FifekAGH/Analogowy-Krehlik/README.md

# Wstępny podział 

Krzysztof - frontend

Dominik - STM32F3 + decoupling, pullupy/downy itp

Filip - LDO, Układ odwracający napięcie, USB,Diody LED :)
