FifekAGH/Analogowy-Krehlik/precise_ammeter/precise_ammeter.kicad_pcb

## KiCad design precise_ammeter/precise_ammeter.kicad_pcb (2025-11-12)

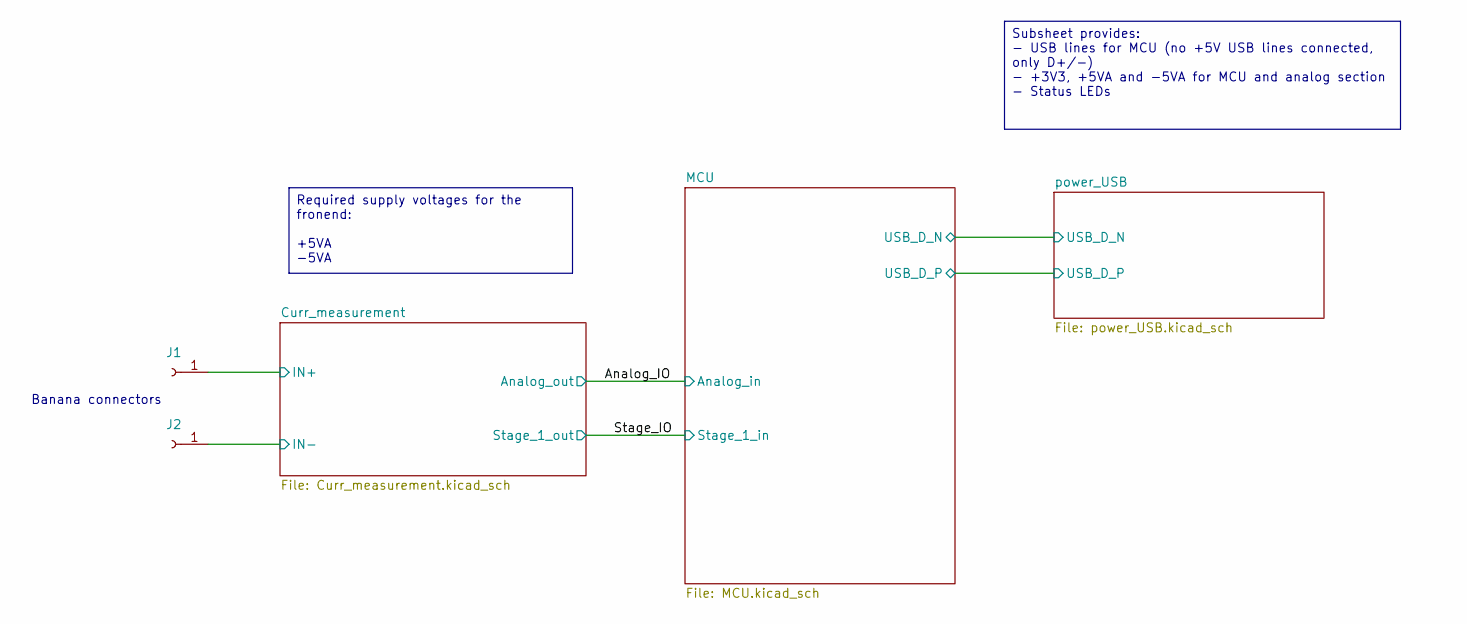
[picture p1: schematic precise_ammeter.kicad_sch]

Parts:
J1, J2: Conn_01x01_Socket; Banana_Jack_1Pin

Connections:
/Curr_measurement/IN+: J1.1; also elsewhere on the board
/Curr_measurement/IN-: J2.1; also elsewhere on the board

Notes on the sheet:
Banana connectors
Required supply voltages for the fronend: +5VA -5VA
Subsheet provides: - USB lines for MCU (no +5V USB lines connected, only D+/-) - +3V3, +5VA and -5VA for MCU and analog section - Status LEDs

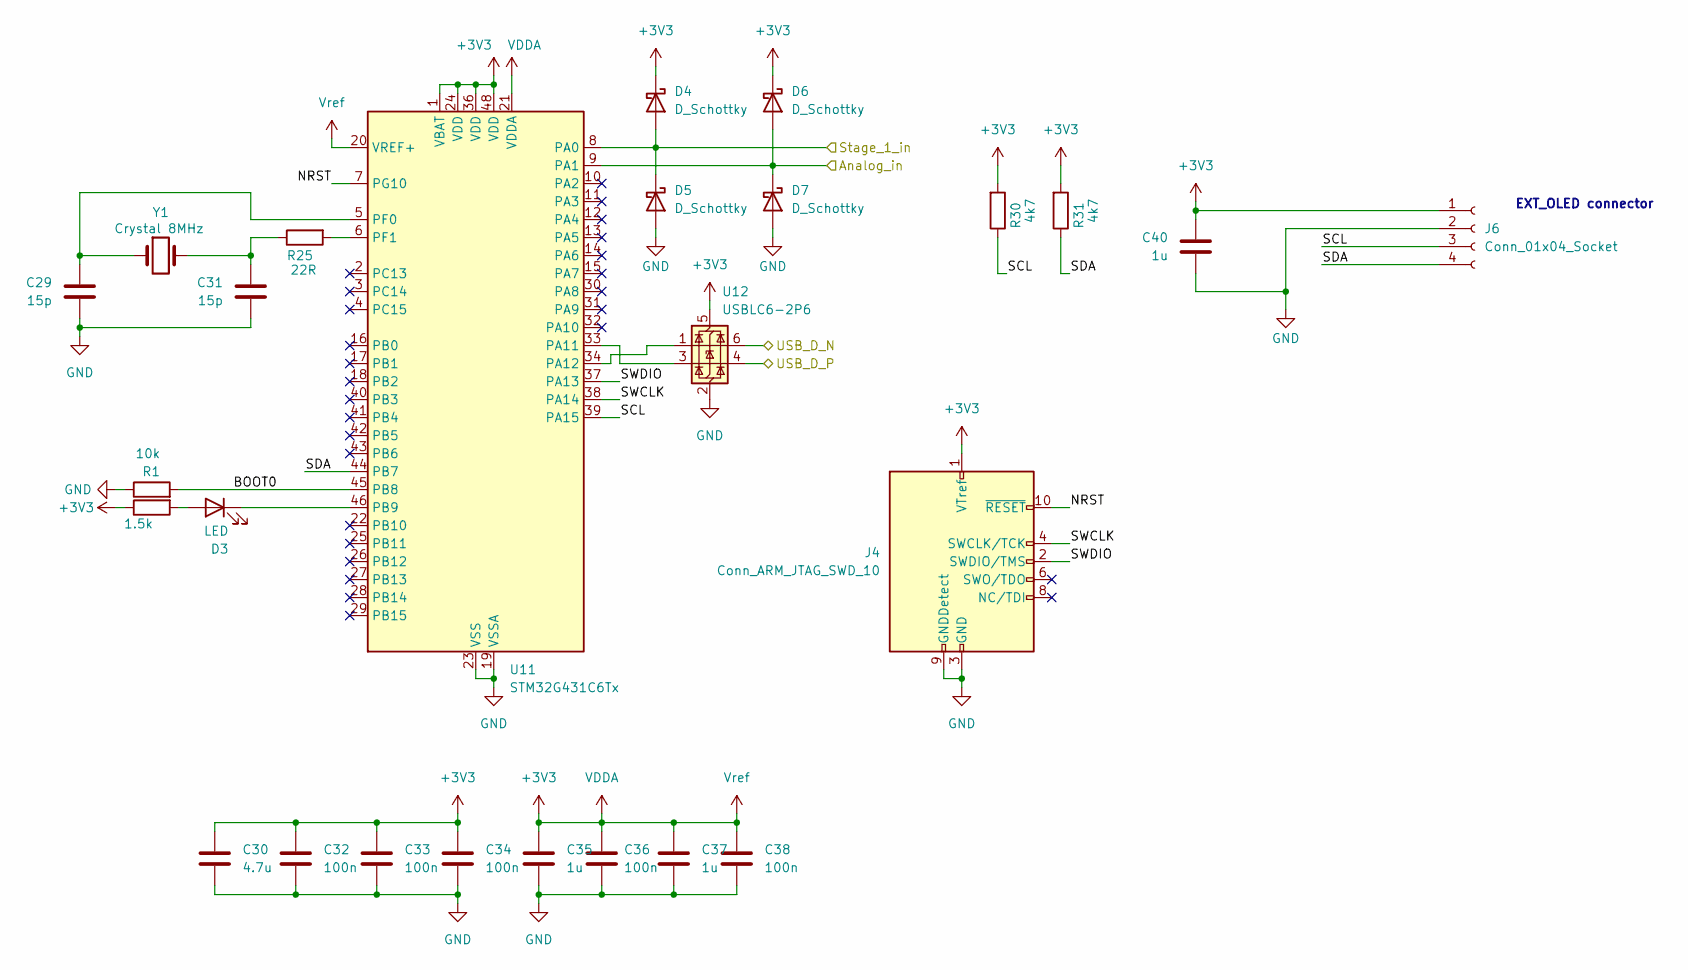
[picture p2: schematic MCU.kicad_sch]

Parts:
C29, C31: 15p; C_0805_2012Metric
C30: 4.7u; C_0805_2012Metric
C32, C33, C34, C36, C38: 100n; C_0805_2012Metric
C35, C37, C40: 1u; C_0805_2012Metric
D3: LED; LED_0805_2012Metric
D4, D5, D6, D7: D_Schottky; D_SOD-123F
J4: Conn_ARM_JTAG_SWD_10; PinHeader_2x05_P1.27mm_Vertical
J6: Conn_01x04_Socket; PinSocket_1x04_P2.54mm_Vertical
R1: 10k; R_0805_2012Metric_Pad1.20x1.40mm_HandSolder
R5: 1.5k; R_0805_2012Metric_Pad1.20x1.40mm_HandSolder
R25: 22R; R_0805_2012Metric_Pad1.20x1.40mm_HandSolder
R30, R31: 4k7; R_0805_2012Metric_Pad1.20x1.40mm_HandSolder
U11: STM32G431C6Tx; LQFP-48_7x7mm_P0.5mm
U12: USBLC6-2P6; SOT-666
Y1: Crystal 8MHz; Crystal_SMD_HC49-SD

Connections:
+3V3: C30.1, C32.1, C33.1, C34.1, C35.1, C36.1, C37.1, C38.1, C40.1, D4.1 (K), D6.1 (K), J4.1 (VTref), J6.1, R5.1, R30.2, R31.2, U11.1 (VBAT), U11.20 (VREF+), U11.21 (VDDA), U11.24 (VDD), U11.36 (VDD), U11.48 (VDD), U12.5 (VBUS); also elsewhere on the board
/Analog_IO: D6.2 (A), D7.1 (K), U11.9 (PA1); also elsewhere on the board
/MCU/BOOT0: R1.2, U11.45 (PB8)
/MCU/NRST: J4.10 (~RESET), U11.7 (PG10)
/MCU/SCL: J6.3, R30.1, U11.39 (PA15)
/MCU/SDA: J6.4, R31.1, U11.44 (PB7)
/MCU/SWCLK: J4.4 (SWCLK/TCK), U11.38 (PA14)
/MCU/SWDIO: J4.2 (SWDIO/TMS), U11.37 (PA13)
/MCU/USB_D_N: U12.6 (I/O1); also elsewhere on the board
/MCU/USB_D_P: U12.4 (I/O2); also elsewhere on the board
/Stage_IO: D4.2 (A), D5.1 (K), U11.8 (PA0); also elsewhere on the board
GND: C29.2, C30.2, C31.2, C32.2, C33.2, C34.2, C35.2, C36.2, C37.2, C38.2, C40.2, D5.2 (A), D7.2 (A), J4.3 (GND), J4.5 (GND), J4.9 (GNDDetect), J6.2, R1.1, U11.19 (VSSA), U11.23 (VSS), U11.35 (VSS), U11.47 (VSS), U12.2 (GND); also elsewhere on the board
unnamed: C31.1, R25.1, Y1.2
unnamed: D3.2 (A), R5.2
unnamed: D3.1 (K), U11.46 (PB9)
unnamed: U11.33 (PA11), U12.3 (I/O2)
unnamed: U11.34 (PA12), U12.1 (I/O1)
unnamed: C29.1, U11.5 (PF0), Y1.1
unnamed: R25.2, U11.6 (PF1)

Notes on the sheet:
EXT_OLED connector

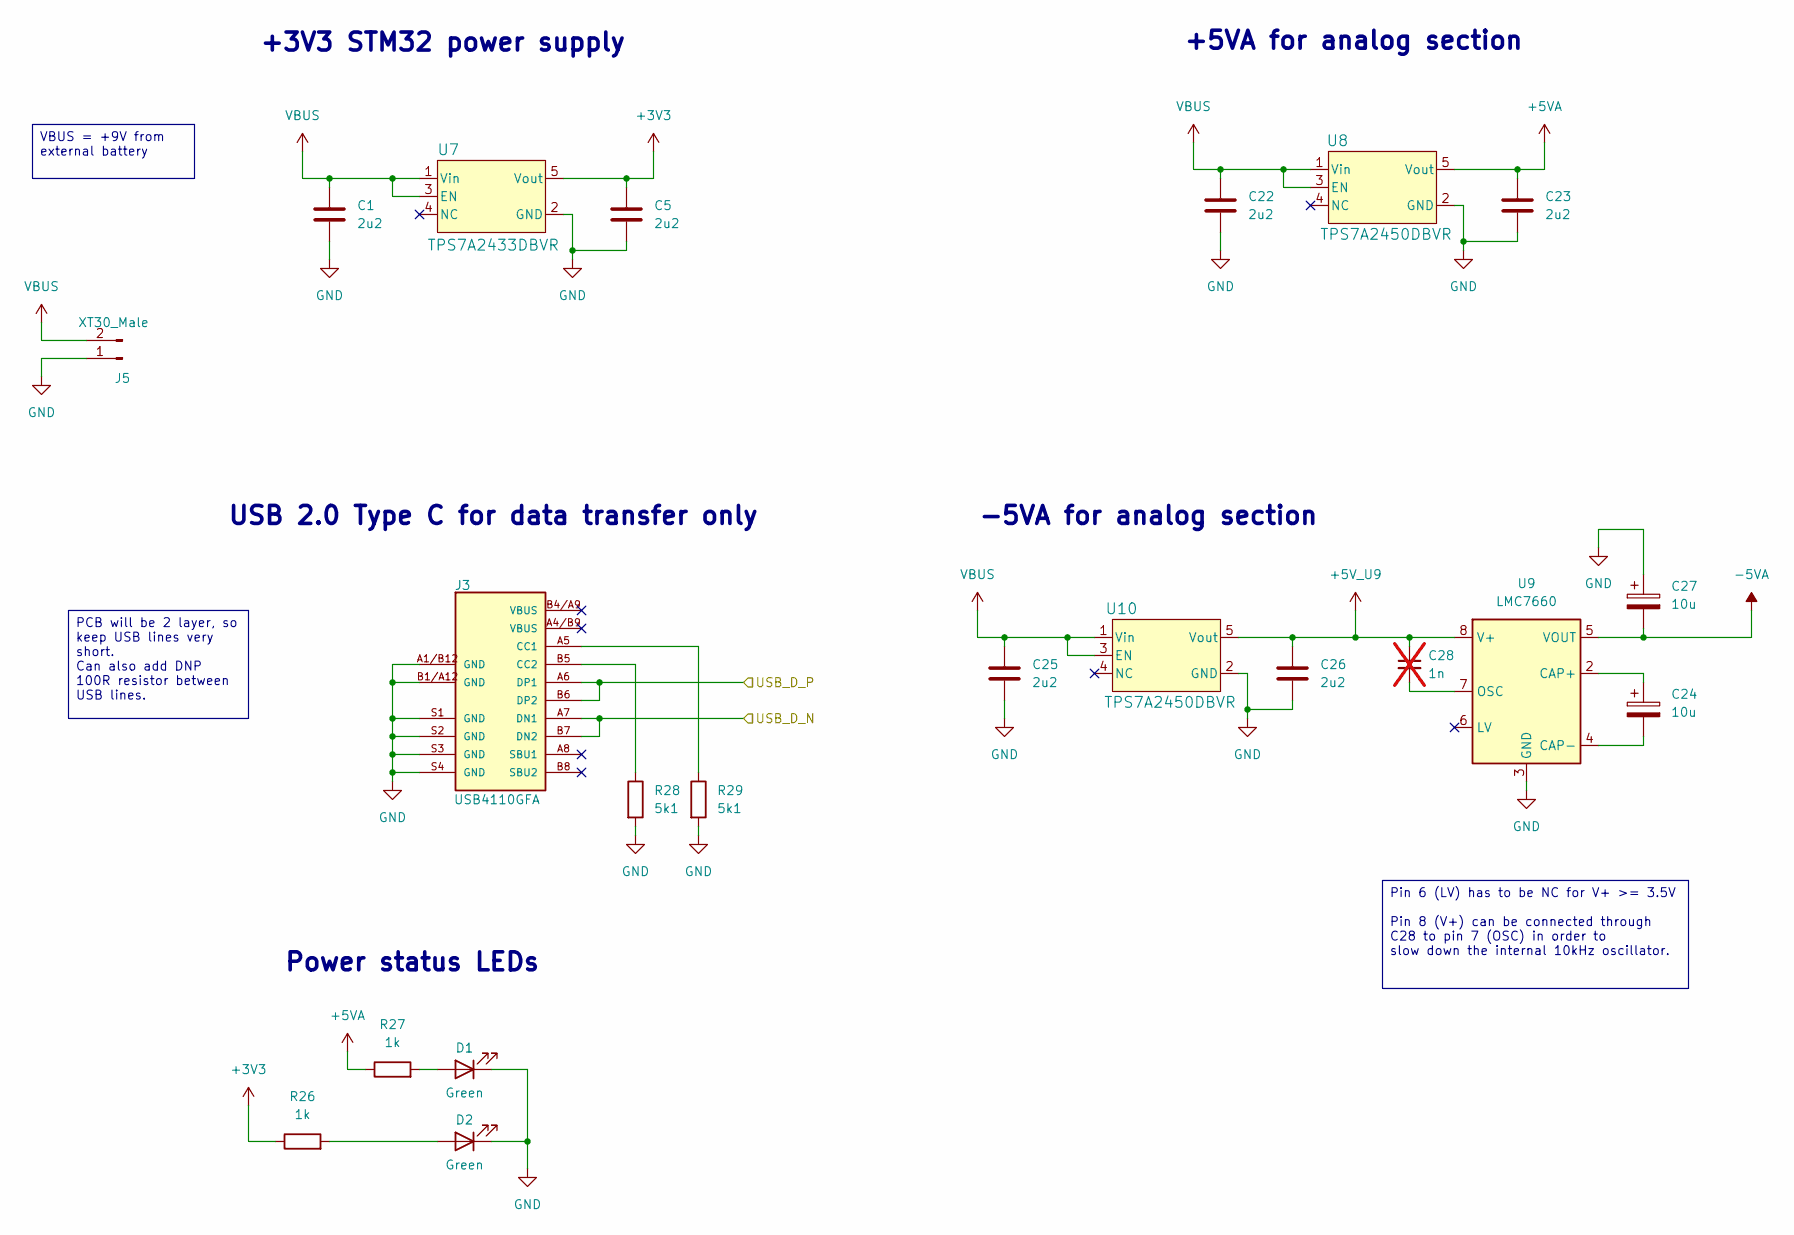
[picture p3: schematic power_USB.kicad_sch]

Parts:
C1, C5, C22, C23, C25, C26: 2u2; C_0805_2012Metric_Pad1.18x1.45mm_HandSolder; DC rating min. 25V
C24, C27: 10u; CP_Elec_4x5.4
C28: 1n; C_0805_2012Metric_Pad1.18x1.45mm_HandSolder; not fitted
D1, D2: Green; LED_0805_2012Metric_Pad1.15x1.40mm_HandSolder
J3: USB4110GFA; GCT_USB4110GFA
J5: XT30_Male; AMASS_XT30UPB-M_1x02_P5.0mm_Vertical
R26, R27: 1k; R_0805_2012Metric_Pad1.20x1.40mm_HandSolder
R28, R29: 5k1; R_0805_2012Metric_Pad1.20x1.40mm_HandSolder
U7: TPS7A2433DBVR; SOT23_DBV_TEX
U8, U10: TPS7A2450DBVR; SOT23_DBV_TEX
U9: LMC7660; SOIC-8_3.9x4.9mm_P1.27mm

Connections:
+3V3: C5.1, R26.1, U7.5 (Vout); also elsewhere on the board
+5VA: C23.1, R27.1, U8.5 (Vout); also elsewhere on the board
+5V_U9: C26.1, C28.1, U9.8 (V+), U10.5 (Vout)
-5VA: C27.2, U9.5 (VOUT); also elsewhere on the board
/MCU/USB_D_N: J3.A7 (DN1), J3.B7 (DN2); also elsewhere on the board
/MCU/USB_D_P: J3.A6 (DP1), J3.B6 (DP2); also elsewhere on the board
GND: C1.2, C5.2, C22.2, C23.2, C25.2, C26.2, C27.1, D1.1 (K), D2.1 (K), J3.A1/B12 (GND), J3.B1/A12 (GND), J3.S1 (GND), J3.S2 (GND), J3.S3 (GND), J3.S4 (GND), J5.1, R28.2, R29.2, U7.2 (GND), U8.2 (GND), U9.3 (GND), U10.2 (GND); also elsewhere on the board
unnamed: D1.2 (A), R27.2
unnamed: D2.2 (A), R26.2
unnamed: J3.A5 (CC1), R29.1
unnamed: J3.B5 (CC2), R28.1
unnamed: C24.1, U9.2 (CAP+)
unnamed: C24.2, U9.4 (CAP-)
unnamed: C28.2, U9.7 (OSC)
VBUS: C1.1, C22.1, C25.1, J5.2, U7.1 (Vin), U7.3 (EN), U8.1 (Vin), U8.3 (EN), U10.1 (Vin), U10.3 (EN)

Notes on the sheet:
-5VA for analog section
+3V3 STM32 power supply
Power status LEDs
+5VA for analog section
USB 2.0 Type C for data transfer only
VBUS = +9V from external battery
PCB will be 2 layer, so keep USB lines very short. Can also add DNP 100R resistor between USB lines.
Pin 6 (LV) has to be NC for V+ >= 3.5V Pin 8 (V+) can be connected through C28 to pin 7 (OSC) in order to slow down the internal 10kHz oscillator.

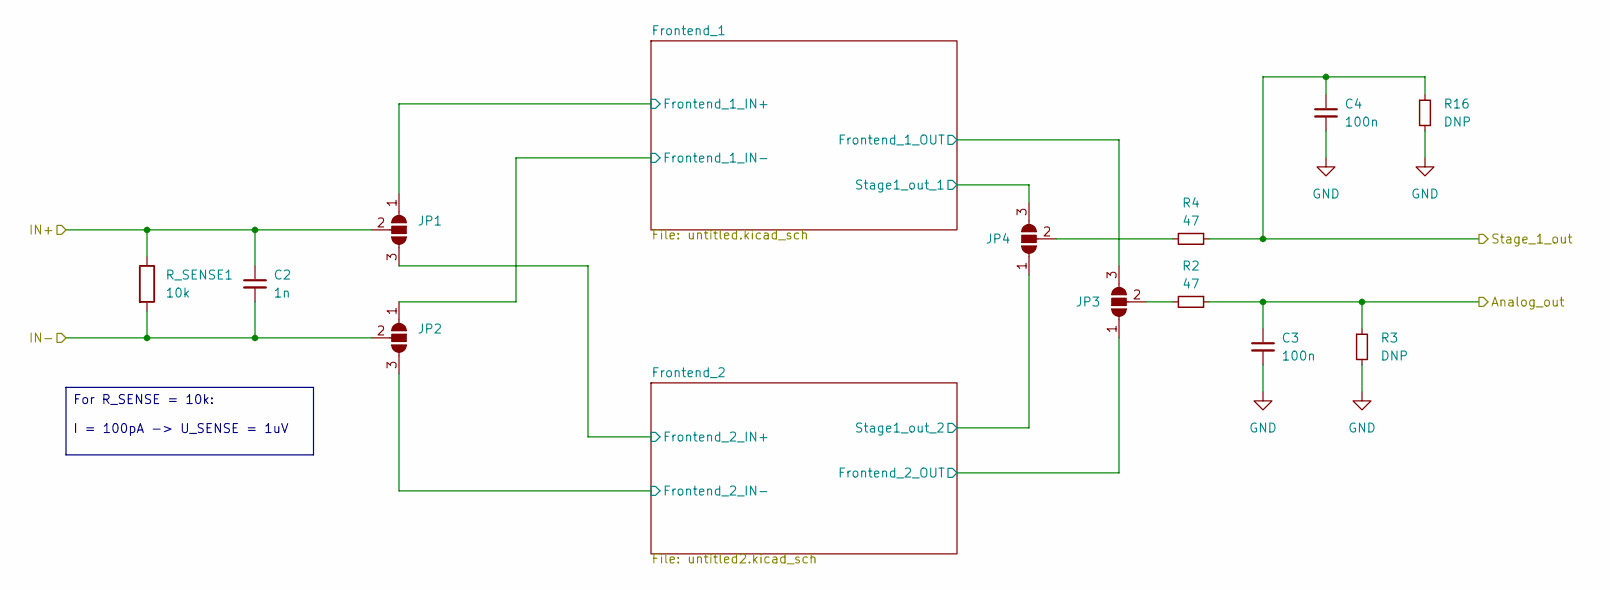
[picture p4: schematic Curr_measurement.kicad_sch]

Parts:
C2: 1n; C_0805_2012Metric_Pad1.18x1.45mm_HandSolder
C3, C4: 100n; C_0805_2012Metric_Pad1.18x1.45mm_HandSolder
JP1, JP2, JP3, JP4: SolderJumper_3_Open; SolderJumper-3_P1.3mm_Open_Pad1.0x1.5mm
R2, R4: 47; R_0805_2012Metric_Pad1.20x1.40mm_HandSolder
R3, R16: DNP; R_0805_2012Metric_Pad1.20x1.40mm_HandSolder
R_SENSE1: 10k; R_1206_3216Metric_Pad1.30x1.75mm_HandSolder

Connections:
/Analog_IO: C3.1, R2.1, R3.1; also elsewhere on the board
/Curr_measurement/Frontend_1/Frontend_1_IN+: JP1.1 (A); also elsewhere on the board
/Curr_measurement/Frontend_1/Frontend_1_IN-: JP2.1 (A); also elsewhere on the board
/Curr_measurement/Frontend_1/Frontend_1_OUT: JP3.3 (B); also elsewhere on the board
/Curr_measurement/Frontend_1/Stage1_out_1: JP4.3 (B); also elsewhere on the board
/Curr_measurement/Frontend_2/Frontend_2_IN+: JP1.3 (B); also elsewhere on the board
/Curr_measurement/Frontend_2/Frontend_2_IN-: JP2.3 (B); also elsewhere on the board
/Curr_measurement/Frontend_2/Frontend_2_OUT: JP3.1 (A); also elsewhere on the board
/Curr_measurement/Frontend_2/Stage1_out_2: JP4.1 (A); also elsewhere on the board
/Curr_measurement/IN+: C2.1, JP1.2 (C), R_SENSE1.1; also elsewhere on the board
/Curr_measurement/IN-: C2.2, JP2.2 (C), R_SENSE1.2; also elsewhere on the board
/Stage_IO: C4.1, R4.1, R16.1; also elsewhere on the board
GND: C3.2, C4.2, R3.2, R16.2; also elsewhere on the board
unnamed: JP3.2 (C), R2.2
unnamed: JP4.2 (C), R4.2

Notes on the sheet:
For R_SENSE = 10k: I = 100pA -> U_SENSE = 1uV

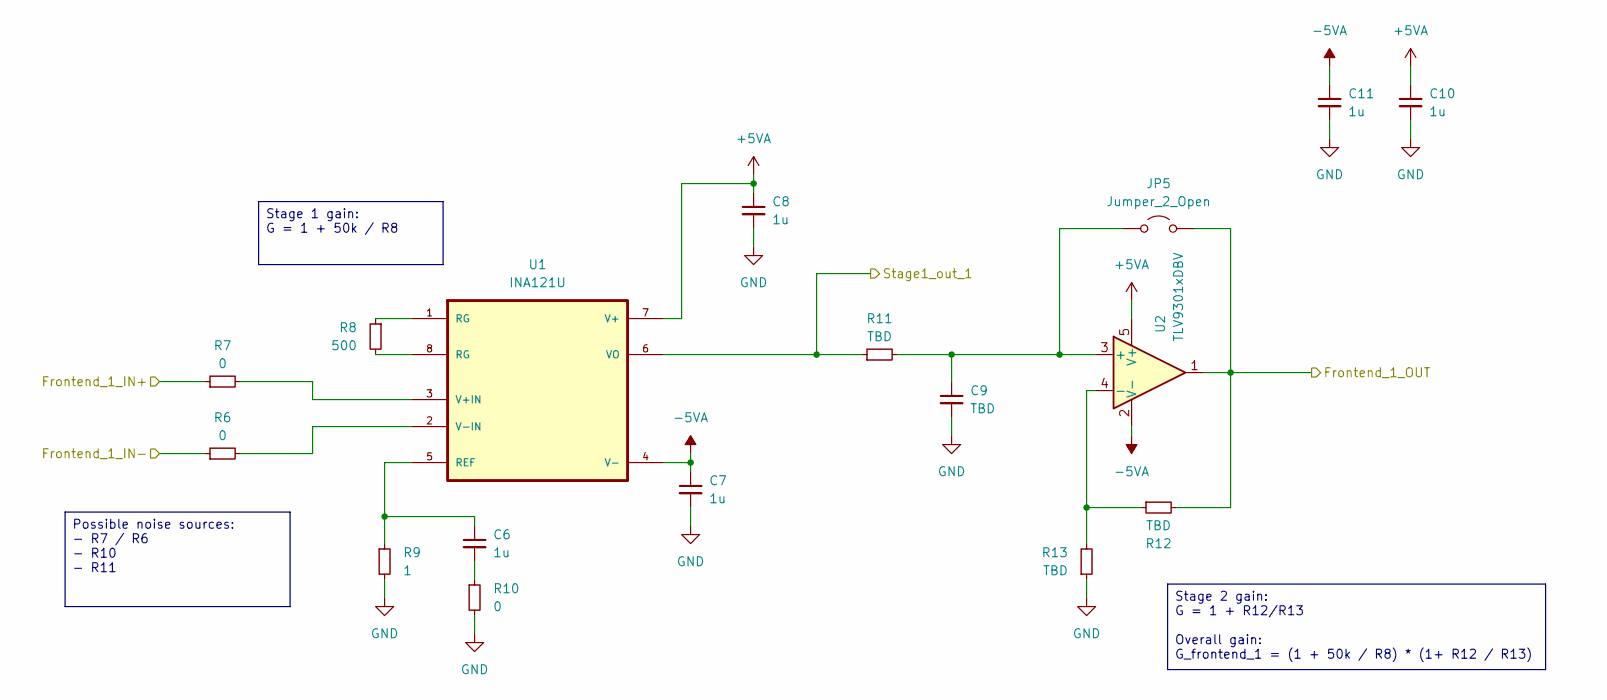
[picture p5: schematic untitled.kicad_sch]

Parts:
C6, C7, C8, C10, C11: 1u; C_0805_2012Metric_Pad1.18x1.45mm_HandSolder
C9: TBD; C_0805_2012Metric_Pad1.18x1.45mm_HandSolder
JP5: Jumper_2_Open; SolderJumper-2_P1.3mm_Open_Pad1.0x1.5mm
R6, R7, R10: 0; R_0805_2012Metric_Pad1.20x1.40mm_HandSolder
R8: 500; R_0805_2012Metric_Pad1.20x1.40mm_HandSolder
R9: 1; R_0805_2012Metric_Pad1.20x1.40mm_HandSolder
R11, R12, R13: TBD; R_0805_2012Metric_Pad1.20x1.40mm_HandSolder
U1: INA121U; DIP-8_W7.62mm_LongPads
U2: TLV9301xDBV; SOT-23-5

Connections:
+5VA: C8.1, C10.1, U1.7 (V+), U2.5 (V+); also elsewhere on the board
-5VA: C7.1, C11.1, U1.4 (V-), U2.2 (V-); also elsewhere on the board
/Curr_measurement/Frontend_1/Frontend_1_IN+: R7.1; also elsewhere on the board
/Curr_measurement/Frontend_1/Frontend_1_IN-: R6.1; also elsewhere on the board
/Curr_measurement/Frontend_1/Frontend_1_OUT: JP5.2 (B), R12.2, U2.1; also elsewhere on the board
/Curr_measurement/Frontend_1/Stage1_out_1: R11.1, U1.6 (VO); also elsewhere on the board
GND: C7.2, C8.2, C9.2, C10.2, C11.2, R9.2, R10.2, R13.1; also elsewhere on the board
unnamed: C6.2, R10.1
unnamed: C9.1, JP5.1 (A), R11.2, U2.3 (+)
unnamed: R8.1, U1.1 (RG)
unnamed: R8.2, U1.8 (RG)
unnamed: C6.1, R9.1, U1.5 (REF)
unnamed: R7.2, U1.3 (V+IN)
unnamed: R6.2, U1.2 (V-IN)
unnamed: R12.1, R13.2, U2.4 (-)

Notes on the sheet:
Stage 1 gain: G = 1 + 50k / R8
Possible noise sources: - R7 / R6 - R10 - R11
Stage 2 gain: G = 1 + R12/R13 Overall gain: G_frontend_1 = (1 + 50k / R8) * (1+ R12 / R13)

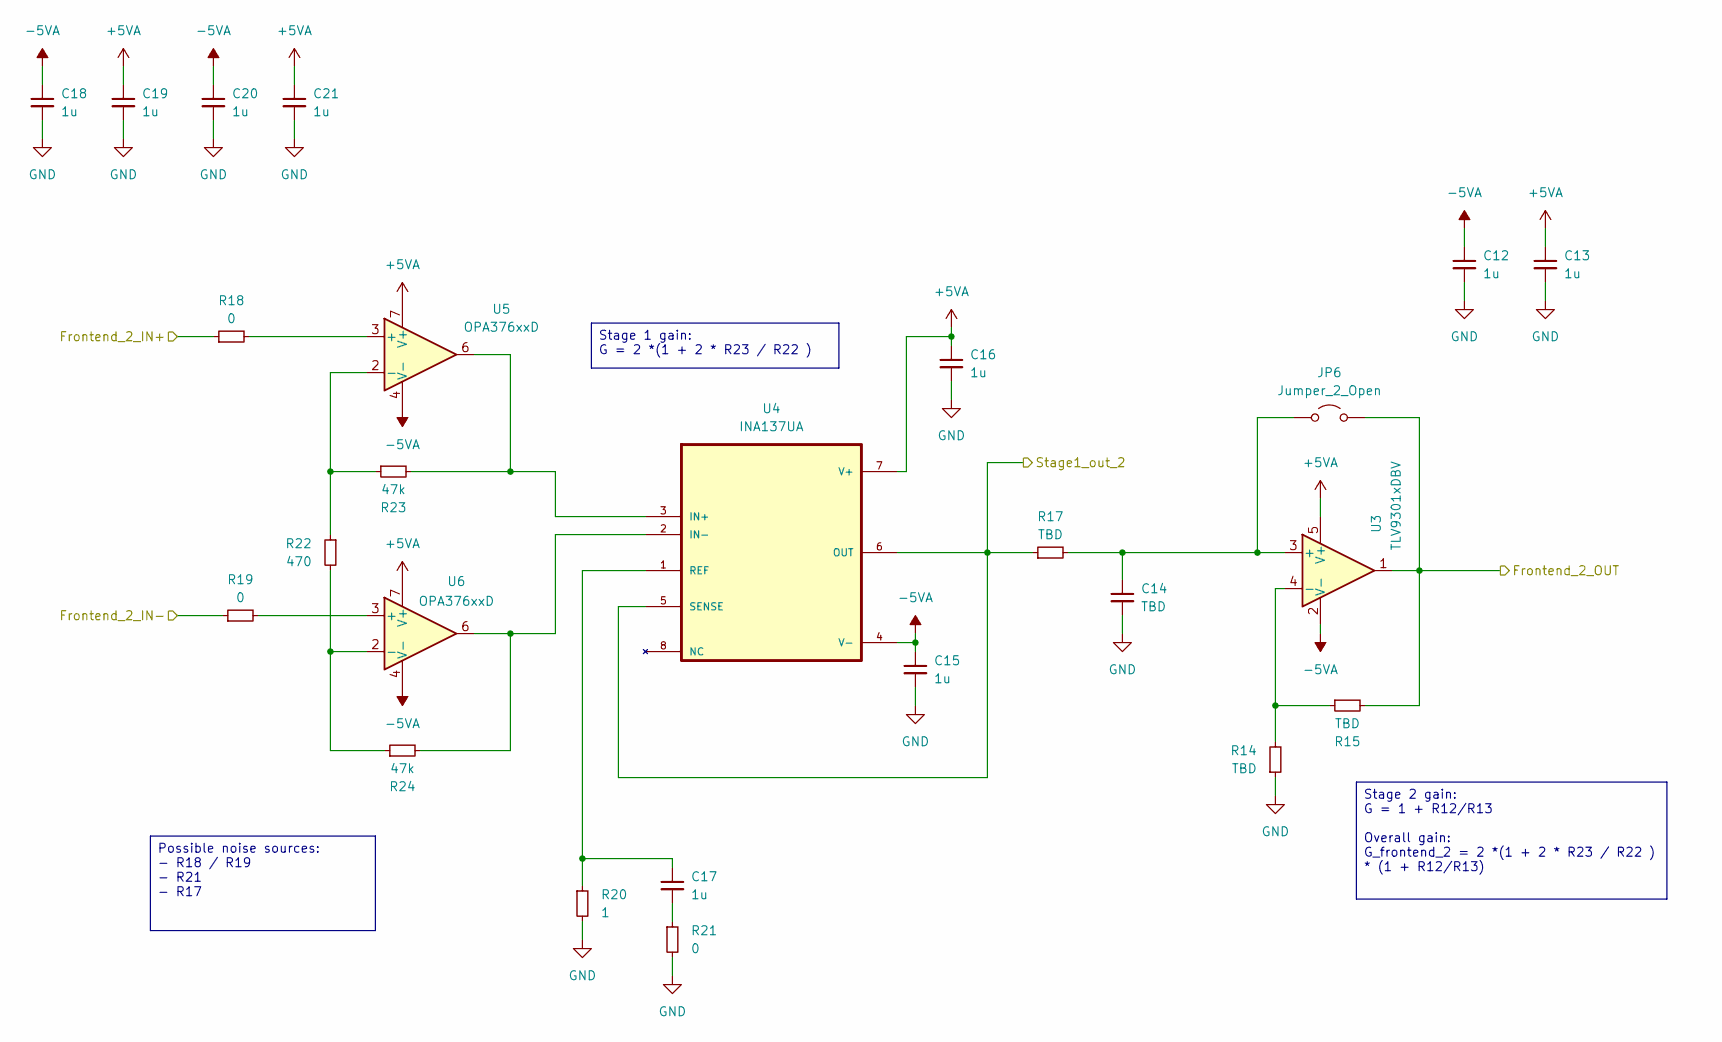
[picture p6: schematic untitled2.kicad_sch]

Parts:
C12, C13, C15, C16, C17, C18, C19, C20, C21: 1u; C_0805_2012Metric_Pad1.18x1.45mm_HandSolder
C14: TBD; C_0805_2012Metric_Pad1.18x1.45mm_HandSolder
JP6: Jumper_2_Open; SolderJumper-2_P1.3mm_Open_Pad1.0x1.5mm
R14, R15, R17: TBD; R_0805_2012Metric_Pad1.20x1.40mm_HandSolder
R18, R19, R21: 0; R_0805_2012Metric_Pad1.20x1.40mm_HandSolder
R20: 1; R_0805_2012Metric_Pad1.20x1.40mm_HandSolder
R22: 470; R_0805_2012Metric_Pad1.20x1.40mm_HandSolder
R23, R24: 47k; R_0805_2012Metric_Pad1.20x1.40mm_HandSolder
U3: TLV9301xDBV; SOT-23-5
U4: INA137UA; SOIC127P599X175-8N
U5, U6: OPA376xxD; SOIC-8_3.9x4.9mm_P1.27mm

Connections:
+5VA: C13.1, C16.1, C19.1, C21.1, U3.5 (V+), U4.7 (V+), U5.7 (V+), U6.7 (V+); also elsewhere on the board
-5VA: C12.1, C15.1, C18.1, C20.1, U3.2 (V-), U4.4 (V-), U5.4 (V-), U6.4 (V-); also elsewhere on the board
/Curr_measurement/Frontend_2/Frontend_2_IN+: R18.1; also elsewhere on the board
/Curr_measurement/Frontend_2/Frontend_2_IN-: R19.1; also elsewhere on the board
/Curr_measurement/Frontend_2/Frontend_2_OUT: JP6.2 (B), R15.2, U3.1; also elsewhere on the board
/Curr_measurement/Frontend_2/Stage1_out_2: R17.1, U4.5 (SENSE), U4.6 (OUT); also elsewhere on the board
GND: C12.2, C13.2, C14.2, C15.2, C16.2, C18.2, C19.2, C20.2, C21.2, R14.1, R20.2, R21.2; also elsewhere on the board
unnamed: C17.2, R21.1
unnamed: C14.1, JP6.1 (A), R17.2, U3.3 (+)
unnamed: R14.2, R15.1, U3.4 (-)
unnamed: R23.2, U4.3 (IN+), U5.6
unnamed: R24.2, U4.2 (IN-), U6.6
unnamed: C17.1, R20.1, U4.1 (REF)
unnamed: R18.2, U5.3 (+)
unnamed: R22.1, R23.1, U5.2 (-)
unnamed: R19.2, U6.3 (+)
unnamed: R22.2, R24.1, U6.2 (-)

Notes on the sheet:
Stage 2 gain: G = 1 + R12/R13 Overall gain: G_frontend_2 = 2 *(1 + 2 * R23 / R22 ) * (1 + R12/R13)
Possible noise sources: - R18 / R19 - R21 - R17
Stage 1 gain: G = 2 *(1 + 2 * R23 / R22 )

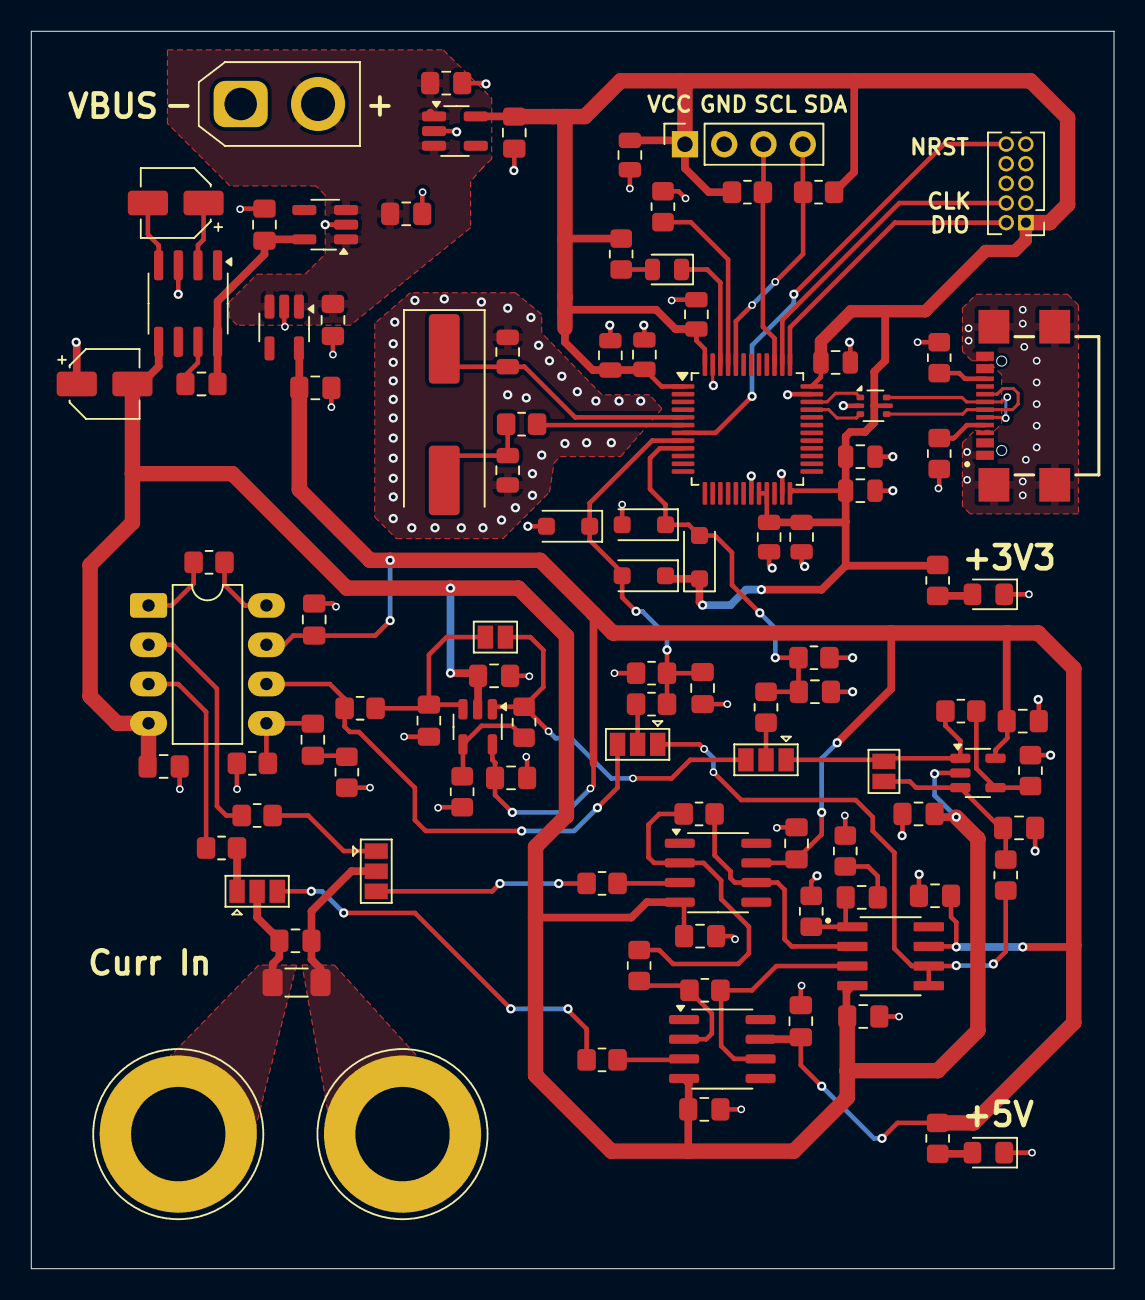
[picture p7: board precise_ammeter.kicad_pcb from above]

Board: 2 copper layers, 70.0 x 80.0 mm, 103 parts (0 on the bottom side), 60 nets.
