FifekAGH/Analogowy-Krehlik/firmware/bsp/STM32G431C6TX/STM32G431C6TX.ioc

Mcu.UserName=STM32G431C6Tx
PA0.Signal=ADC1_IN1
PA1.Signal=ADC1_IN2
PA15.Signal=I2C1_SCL
PB7.Signal=I2C1_SDA
PB9.GPIO_Label=LED
PB9.Signal=GPIO_Output
PF0-OSC_IN.Signal=RCC_OSC_IN
PF1-OSC_OUT.Signal=RCC_OSC_OUT
