FifekAGH/Analogowy-Krehlik/firmware/bsp/STM32G431C6TX/src/bsp_adc.cpp

#include "bsp_adc.hpp"

#include "adc.h"
#include "stm32g4xx_hal_adc.h"
#include "stm32g4xx_hal_adc_ex.h"
#include "stm32g4xx_hal_def.h"
#include <cstdint>
#include <cstring>

enum {
  ADC_CHANNEL_COUNT = 2,
};

volatile bsp::adc::OnConversion onConversionComplete = nullptr;

void HAL_ADC_ConvCpltCallback(ADC_HandleTypeDef *hadc) {
  uint32_t value = HAL_ADC_GetValue(&hadc1);
  if (onConversionComplete) {
    onConversionComplete(value);
  }
}

namespace bsp::adc {

bool calibrate(void) {
  if (HAL_OK != HAL_ADCEx_Calibration_Start(&hadc1, ADC_SINGLE_ENDED)) {
    return false;
  }
  return true;
}

uint32_t readChannelPolling() {
  HAL_ADC_Start(&hadc1);
  if (HAL_OK == HAL_ADC_PollForConversion(&hadc1, HAL_MAX_DELAY)) {
    return HAL_ADC_GetValue(&hadc1);
  }
  return 0;
}

void disableInterrupts() { HAL_NVIC_DisableIRQ(ADC1_2_IRQn); }

void enableInterrupts() { HAL_NVIC_EnableIRQ(ADC1_2_IRQn); }

void readChannel(OnConversion callback) {
  onConversionComplete = callback;
  HAL_ADC_Start_IT(&hadc1);
}

}; // namespace bsp::adc
