FifekAGH/Analogowy-Krehlik/firmware/bsp/STM32F429ZIT/src/bsp_adc.cpp

#include "bsp_adc.hpp"

#include "adc.h"
#include "stm32f4xx_hal.h"
#include "stm32f4xx_hal_adc.h"
#include "stm32f4xx_hal_adc_ex.h"
#include "stm32f4xx_hal_def.h"
#include <cstdint>
#include <signal.h>

enum {
  ADC_CHANNEL_COUNT = 2,
};

namespace {
uint32_t getChannel(uint8_t channel) {
  switch (channel) {
  case 0:
    return ADC_CHANNEL_4;
  case 1:
    return ADC_CHANNEL_5;
  default:
    return ADC_CHANNEL_VREFINT;
  };
}

} // namespace

namespace bsp::adc {

uint32_t readChannelPolling(uint8_t channel) {
  ADC_ChannelConfTypeDef sConfig;
  sConfig.Channel = getChannel(channel);
  HAL_StatusTypeDef status = HAL_ADC_ConfigChannel(&hadc3, &sConfig);
  if (status != HAL_OK) {
    return 0;
  }

  HAL_ADC_Start(&hadc3);
  if (HAL_OK == HAL_ADC_PollForConversion(&hadc3, HAL_MAX_DELAY)) {
    return HAL_ADC_GetValue(&hadc3);
  }
  return 0;
}

}; // namespace bsp::adc
