FifekAGH/Analogowy-Krehlik/(commit log)

2025-10-28 Stworzony projekt KiCad 9.Utworzone 3 sheety hierarchiczne do podzialu
    [Curr_measurement.kicad_sch, MCU.kicad_sch, power_USB.kicad_sch, precise_ammeter.kicad_pcb, precise_ammeter.kicad_sch]
2025-11-01 Dodano schemat frontend_1
    [Curr_measurement.kicad_sch, precise_ammeter.kicad_sch, untitled.kicad_sch, untitled2.kicad_sch]
2025-11-02 Dodano drugi schemat frontendu
    [Curr_measurement.kicad_sch, precise_ammeter.kicad_sch, untitled.kicad_sch, untitled2.kicad_sch]
2025-11-03 Dodano Sekcje zasilanie MCU i wzmacniaczy oraz konektor USB
    [power_USB.kicad_sch, precise_ammeter.kicad_sch]
2025-11-03 added mcu part
    [MCU.kicad_sch, precise_ammeter.kicad_sch]
2025-11-03 dodano rezystory do diod LED
    [power_USB.kicad_sch]
2025-11-03 Dodane pull down na piny CC USB
    [power_USB.kicad_sch]
2025-11-03 fixed mcu schematic
    [MCU.kicad_sch]
2025-11-03 Dodano konektor XT30 dla baterii i zrobiono adnotacj diod Schotkiego na schemacie MCU
    [MCU.kicad_sch, power_USB.kicad_sch]
2025-11-08 adding 1 more 10u cap at voltage inverter
    [power_USB.kicad_sch]
2025-11-08 adding OLED display
    [MCU.kicad_sch]
2025-11-08 Corrected all footprints before starting layout
    [MCU.kicad_sch, untitled.kicad_sch, untitled2.kicad_sch]
2025-11-08 added step model for xt30
    [power_USB.kicad_sch, precise_ammeter.kicad_pcb, precise_ammeter.kicad_sch]
2025-11-08 layout started
    [power_USB.kicad_sch, precise_ammeter.kicad_pcb]
2025-11-08 USB layout
    [MCU.kicad_sch, precise_ammeter.kicad_pcb]
2025-11-09 placement finished
    [power_USB.kicad_sch, precise_ammeter.kicad_pcb]
2025-11-09 placement changed
    [precise_ammeter.kicad_pcb]
2025-11-09 jebane gowno
    [power_USB.kicad_sch, precise_ammeter.kicad_pcb, precise_ammeter.kicad_sch]
2025-11-09 layout almost done. Need to connect Curr_in and fix warnings
    [precise_ammeter.kicad_pcb]
2025-11-09 Layout Done, DRC done
    [power_USB.kicad_sch, precise_ammeter.kicad_pcb]
2025-11-09 dodane teardrops
    [precise_ammeter.kicad_pcb]
2025-11-12 przesunieto konektory LCD i SWD. Przesunieto diode LED 3v3
    [precise_ammeter.kicad_pcb]
2026-01-11 wip: adjust filtering to meet requirements
